WPIRoboticsEngineering/ZenDriver/README.md

# ZenDriver
