WPIRoboticsEngineering/ZenDriver/PCBWay-BOM.xls

 |  |  | xxxx xxxx xxxxx xxPCS BOM (Sample Bill of Materials)
Item # | *Designator | *Qty | Manufacturer | *Mfg Part # | Substitute | Description / Value | *Package/Footprint | Type | Your Instructions / Notes
1 | C1 C15 C16 C17 | 2 | "United Chemi-Con" | "EMVE160ADA221MF80G" |  | "CAP ALUM 220UF 20% 16V SMD" | Nonstandard | SMD
2 | C13 C14 | 2 | "Samsung Electro-Mechanics" | "CL10A475KO8NNNC" | Yes, with equiv | "CAP CER 4.7UF 16V X5R 0603" | SMD 0603 | SMD
3 | C3 C10 C11 C12 C2 | 5 | "Yageo" | "CC0603MRX5R7BB106" | Yes, with equiv | "CAP CER 10UF 16V X5R 0603" | SMD 0603 | SMD
4 | C4 C5 C6 C7 C8 C21 | 6 | "Samsung Electro-Mechanics" | "CL10B104KO8NNNC" | Yes, with equiv | "CAP CER 0.1UF 16V X7R 0603" | SMD 0603 | SMD
5 | C9 | 1 | "Samsung Electro-Mechanics" | "CL10B105KP8NNNC" | Yes, with equiv | "CAP CER 1UF 10V X7R 0603" | SMD 0603 | SMD
6 | D1 | 1 | "Nexperia USA Inc." | "PDZ3.3B |  | "DIODE ZENER 3.3V 400MW SOD323" | SOD323 | SMD
7 | D2 D4 D5 | 3 | "Nexperia USA Inc." | "PMEG4005EJ |  | "DIODE SCHOTTKY 40V 500MA SOD323F" | SOD323F | SMD
8 | D3 | 1 | "Nexperia USA Inc." | "PMEG4005EJ |  | "DIODE SCHOTTKY 40V 500MA SOD323F" | SOD323F | SMD
9 | D8 | 1 | "Würth Elektronik" | "150060RS75000" | Yes, with equiv | "LED RED CLEAR 0603 SMD" | SMD 0603 | SMD
10 | J1 | 1 | "Adam Tech" | "PH1-04-UA" | yes | "CONN HEADER VERT 4POS 2.54MM" | PTH | thru-hole
11 | J10 | 1 | "JST Sales America Inc." | "SM06B-GHS-TB(LF)(SN)" | yes | "CONN HEADER SMD R/A 6POS 1.25MM" | PTH | thru-hole
12 | J11 | 1 | "JST Sales America Inc." | "SM02B-PASS-TBT(LF)(SN)" | yes | "CONN HEADER SMD R/A 2POS 2MM" | PTH | thru-hole
13 | J12 J13 | 2 | Samtec Inc. | “‎SLW-106-01-T-S‎” |  | CONN RCPT 6POS 0.1 TIN PCB | PTH | thru-hole
14 | J2 | 1 | "Sullins Connector Solutions" | "PPTC191LFBN-RC" | yes | "CONN HDR 19POS 0.1 TIN PCB" | PTH | thru-hole
15 | J4 J3 | 2 | "Sullins Connector Solutions" | "PPPC031LFBN-RC" | yes | "CONN HDR 3POS 0.1 GOLD PCB" | PTH | thru-hole
16 | J5 J14 J15 | 3 | "Sullins Connector Solutions" | "PPPC121LFBN-RC" | yes | "CONN HDR 12POS 0.1 GOLD PCB" | PTH | thru-hole
17 | J6 | 1 | "Sullins Connector Solutions" | "PPPC192LFBN-RC" | yes | "CONN HDR 38POS 0.1 GOLD PCB" | PTH | thru-hole
18 | J7 | 1 | "Adam Tech" | "PH1-04-UA" |  | "CONN HEADER VERT 4POS 2.54MM" | PTH | thru-hole
19 | J8 | 1 | "Sullins Connector Solutions" | "PPPC061LFBN-RC" | yes | "CONN HDR 6POS 0.1 GOLD PCB" | PTH | thru-hole
20 | J9 | 1 | "Sullins Connector Solutions" | "PPPC041LFBN-RC" | yes | "CONN HDR 4POS 0.1 GOLD PCB" | PTH | thru-hole
21 | L1 | 1 | "Murata Electronics" | "1255AY-4R7M=P3" |  | "FIXED IND 4.7UH 4A 27.6 MOHM SMD" | Nonstandard | SMD
22 | Q2 Q1 | 2 | "Vishay Siliconix" | "SI7415DN-T1-E3" |  | "MOSFET P-CH 60V 3.6A 1212-8" | PowerPAK® 1212-8 | SMD
23 | R1 R9 R10 | 3 | "Stackpole Electronics Inc" | "RNCP0603FTD10K0" | Yes, with equiv | "RES 10K OHM 1% 1/8W 0603" | SMD 0603 | SMD
24 | R2 | 1 | "Yageo" | "RT0603FRE07270KL" | Yes, with equiv | "RES SMD 270K OHM 1% 1/10W 0603" | SMD 0603 | SMD
25 | R25 | 1 | "Stackpole Electronics Inc" | "RMCF0603JT330R" | Yes, with equiv | "RES 330 OHM 5% 1/10W 0603" | SMD 0603 | SMD
26 | R3 | 1 | “Bourns Inc.” | “CR0603-FX-5112ELF” | Yes, with equiv | 51.1 ±1% 0.1W, 1/10W Chip Resistor 0603 (1608 Metric) Moisture Resistant Thick Film | SMD 0603 | SMD
27 | R4 | 1 | "Yageo" | "RC0603FR-0722R1L" | Yes, with equiv | "RES SMD 22.1 OHM 1% 1/10W 0603" | SMD 0603 | SMD
28 | R5 | 1 | "Stackpole Electronics Inc" | "RMCF0603FT7K68" | Yes, with equiv | "RES 7.68K OHM 1% 1/10W 0603" | SMD 0603 | SMD
29 | R6 | 1 | "Stackpole Electronics Inc" | "RMCF0603FT41K2" | Yes, with equiv | "RES 41.2K OHM 1% 1/10W 0603" | SMD 0603 | SMD
30 | R7 R8 R17 R15 R16 R14 | 6 | "Stackpole Electronics Inc" | "RMCF0603FG100K" | Yes, with equiv | "RES 100K OHM 1% 1/10W 0603" | SMD 0603 | SMD
31 | SW1 | 1 | "Nidec Copal Electronics" | "CSS-1210TB" |  | "SWITCH SLIDE SPDT 100MA 12V" | Nonstandard | SMD
32 | SW2 | 1 | "Nidec Copal Electronics" | "CSS-1210TB" |  | "SWITCH SLIDE SPDT 100MA 12V" | Nonstandard | SMD
33 | U1 | 1 | "Monolithic Power Systems Inc." | "MP4423HGQ-Z" |  | "IC REG BUCK ADJUSTABLE 3A 8QFN" | 8QFN | SMD
34 | U3 U2 | 2 | "Texas Instruments" | "DRV8838DSGT" |  | "IC BRIDGE DRIVER PAR 8WSON" | 8WSON | SMD
35 | U5 | 1 | "STMicroelectronics" | "LSM6DS33TR" |  | "IMU ACCEL/GYRO I2C/SPI 16LGA" | 16LGA | SMD
36 | U4 | 1 | "Vishay Semiconductor Opto Division" | "TSSP58038" |  | "SENSOR REMOTE REC 38.0KHZ 25M" | PTH | thru-hole
