WPIRoboticsEngineering/ZenDriver/outline.dxf

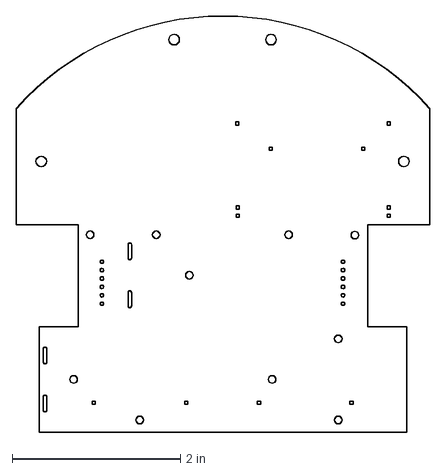
[picture p1: CAD file, 2020-09-22]
outline.dxf
4.93 x 4.95 in
