WPIRoboticsEngineering/ZenDriver/(list of files, drawings)

Other design files:
Romi-unified-board.dsn
