WPIRoboticsEngineering/ZenDriver/Romi-unified-board-2layer.kicad_pcb

## KiCad design Romi-unified-board-2layer.kicad_pcb (2021-03-24)

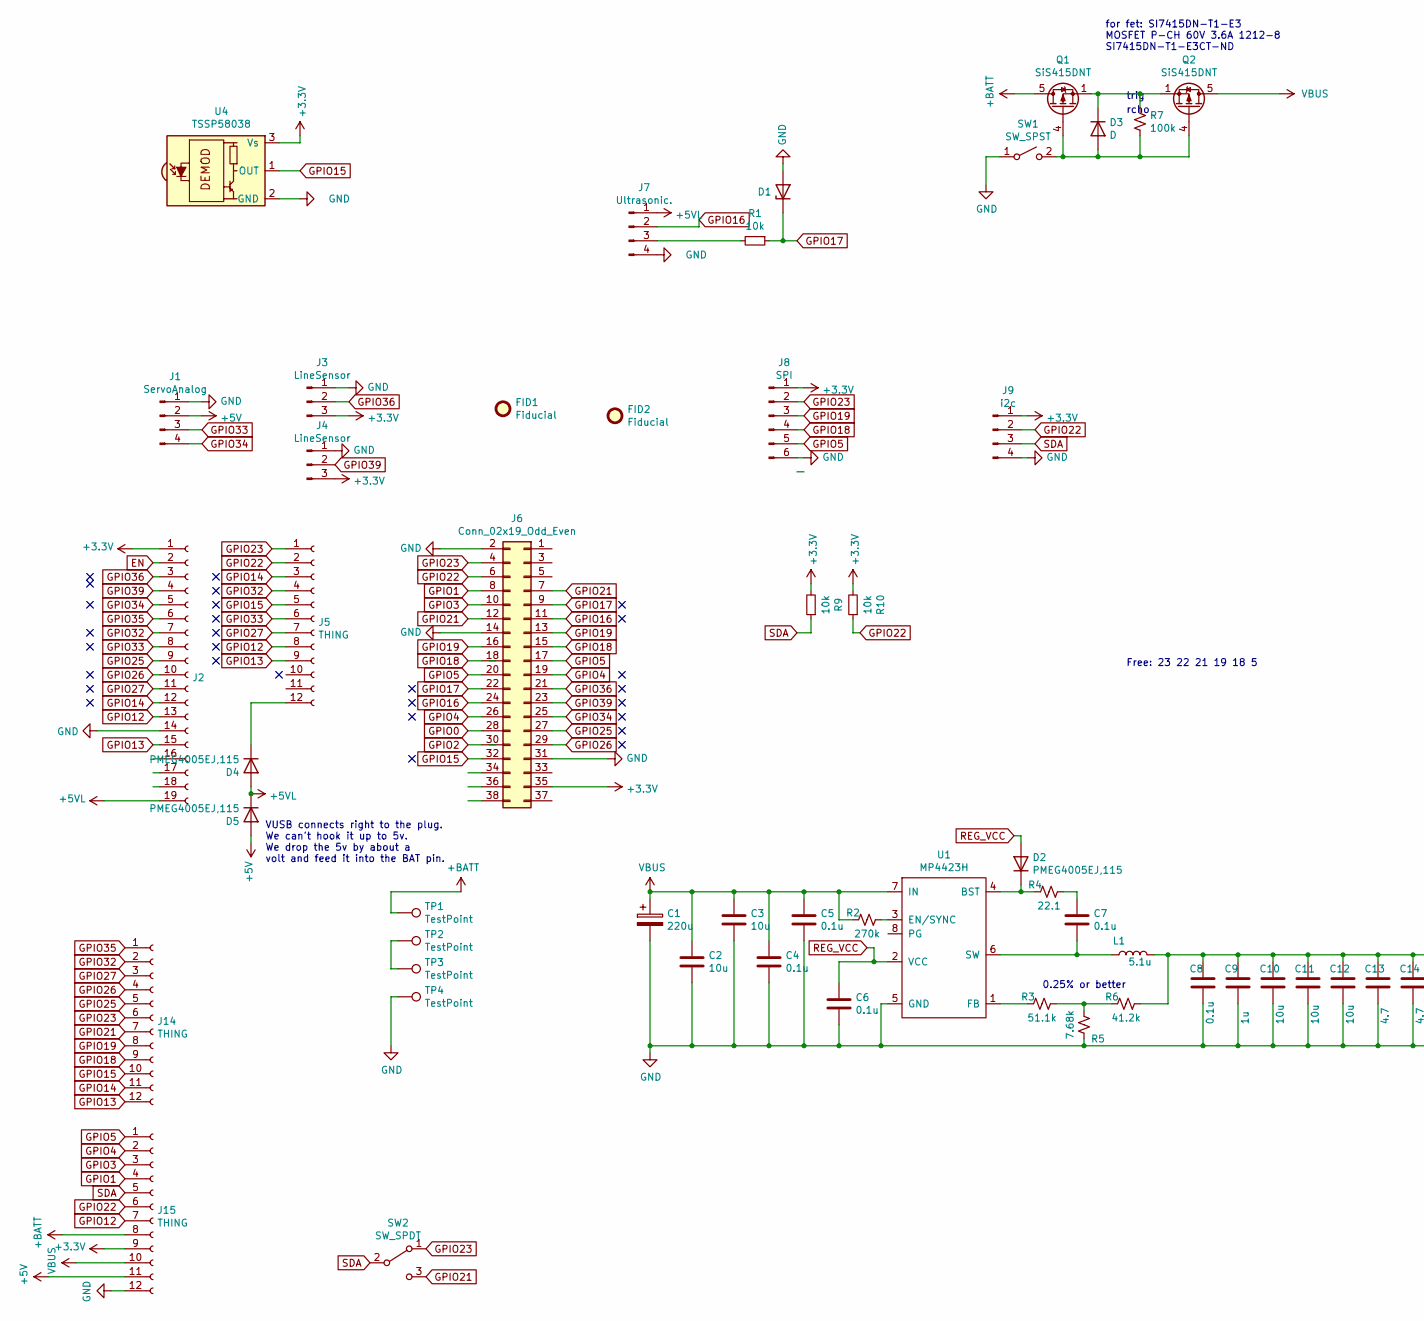
[picture p2: schematic Romi-unified-board-2layer.sch, part in row 1, column 1]

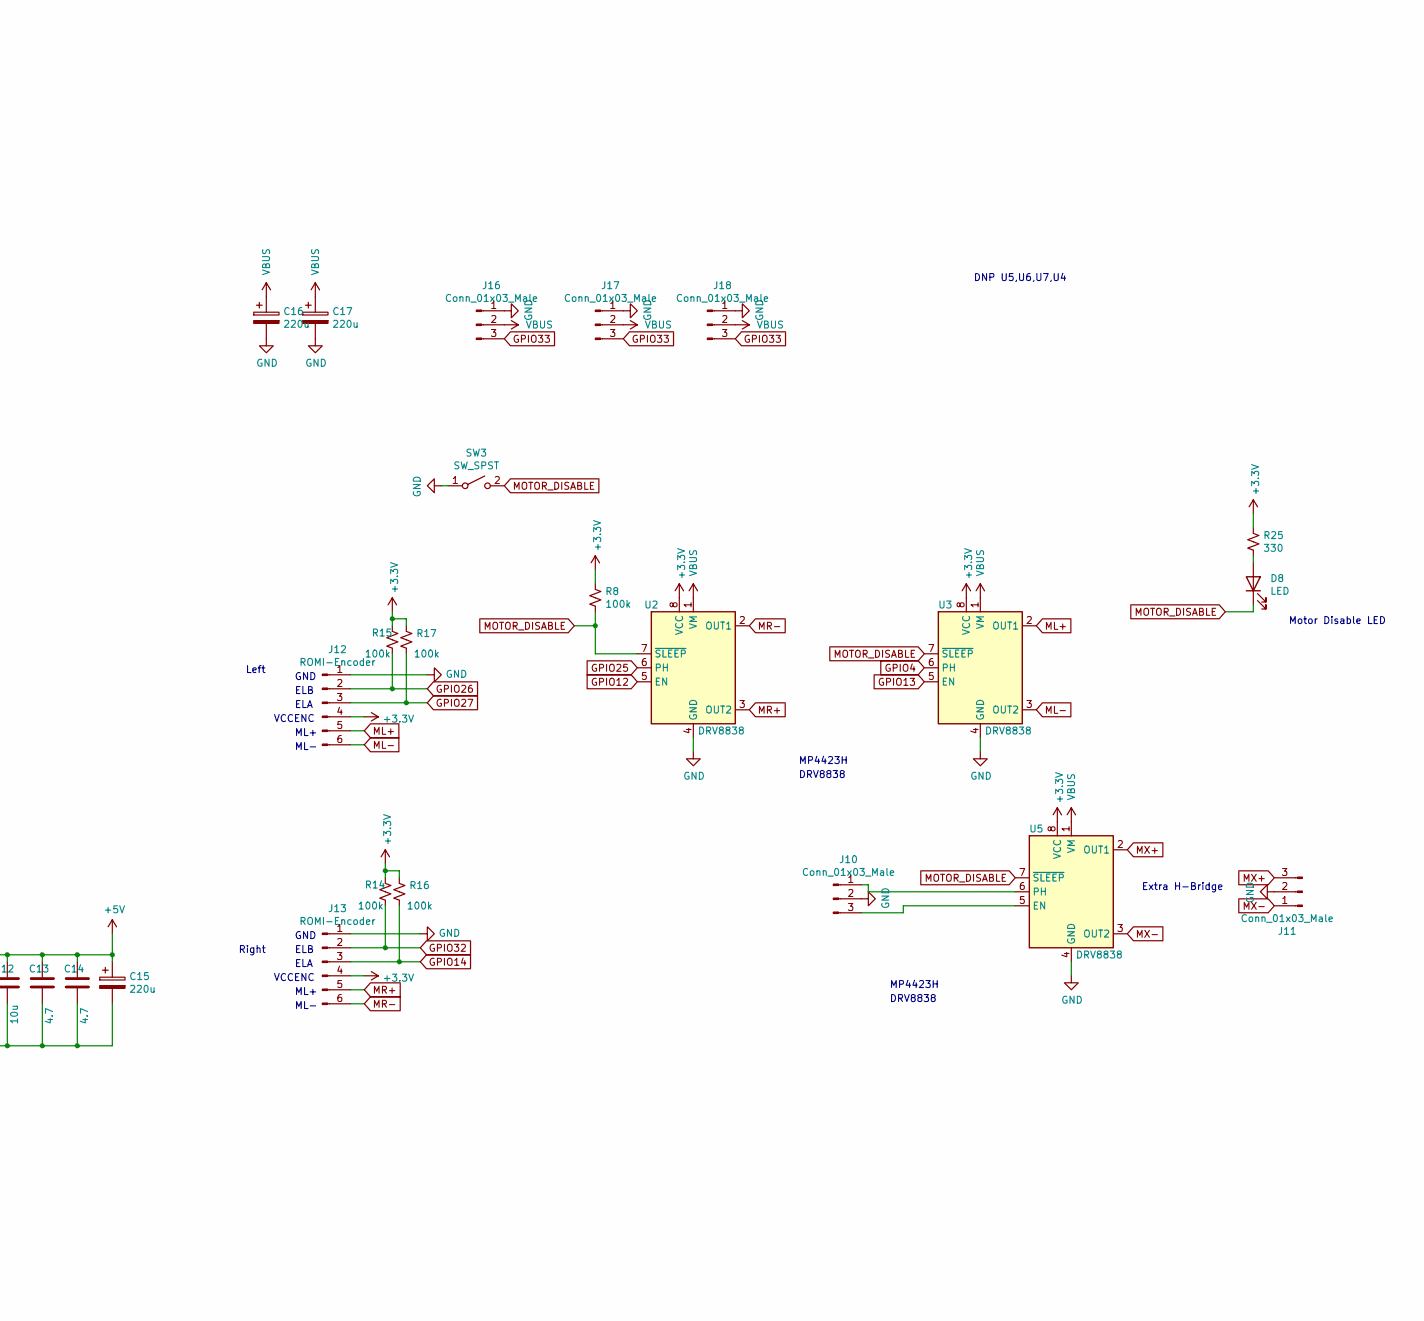
[picture p3: schematic Romi-unified-board-2layer.sch, part in row 1, column 2]

Parts:
C1, C15, C16, C17: 220u; CP_Elec_6.3x3.9
C2, C3, C10, C11, C12: 10u; C_0603_1608Metric
C4, C5, C6, C7, C8: 0.1u; C_0603_1608Metric
C9: 1u; C_0603_1608Metric
C13, C14: 4.7; C_0603_1608Metric
D1: D_Zener; D_SOD-323F
D2, D4, D5: PMEG4005EJ,115; D_SOD-323F
D3: D; D_SOD-323F
D8: LED; LED_0603_1608Metric
FID1, FID2: Fiducial; Fiducial_1mm_Mask2mm
J1: ServoAnalog; PinSocket_1x04_P2.54mm_Vertical
J2: Conn_01x19_Female; PinSocket_1x19_P2.54mm_Vertical
J3, J4: LineSensor; PinSocket_1x03_P2.54mm_Vertical
J5, J14, J15: THING; PinSocket_1x12_P2.54mm_Vertical
J6: Conn_02x19_Odd_Even; PinSocket_2x19_P2.54mm_Vertical
J7: Ultrasonic.; PinSocket_1x04_P2.54mm_Vertical
J8: SPI; PinSocket_1x06_P2.54mm_Vertical
J9: i2c; PinSocket_1x04_P2.54mm_Vertical
J10, J11: Conn_01x03_Male; PinSocket_1x03_P2.54mm_Vertical
J12, J13: ROMI-Encoder; PinSocket_1x06_P2.54mm_Vertical
J16, J17, J18: Conn_01x03_Male; JST_PH_B3B-PH-K_1x03_P2.00mm_Vertical
L1: 5.1u; L_6.3x6.3_H3
Q1, Q2: SiS415DNT; Vishay_PowerPAK_1212-8_Single
R1, R9, R10: 10k; R_0603_1608Metric
R2: 270k; R_0603_1608Metric
R3: 51.1k; R_0603_1608Metric
R4: 22.1; R_0603_1608Metric
R5: 7.68k; R_0603_1608Metric
R6: 41.2k; R_0603_1608Metric
R7, R8, R14, R15, R16, R17: 100k; R_0603_1608Metric
R25: 330; R_0603_1608Metric
SW1, SW3: SW_SPST; SS12D06L5
SW2: SW_SPDT; SS12D06L5
TP1, TP2, TP3, TP4: TestPoint; batterylug
U1: MP4423H
U2, U3, U5: DRV8838; WSON-8-1EP_2x2mm_P0.5mm_EP0.9x1.6mm
U4: TSSP58038; Vishay_MINICAST-3Pin

Connections:
+3V3: J2.1, J3.3, J4.3, J6.35, J8.1, J9.1, J12.4, J13.4, J15.9, R8.1, R9.2, R10.2, R14.1, R15.1, R16.1, R17.1, R25.1, U2.8 (VCC), U3.8 (VCC), U4.3 (Vs), U5.8 (VCC)
+5V: C8.1, C9.1, C10.1, C11.1, C12.1, C13.1, C14.1, C15.1, D5.2 (A), J1.2, J15.11, L1.2, R6.1
+5VL: D4.2 (A), D5.1 (K), J2.19, J7.1
+BATT: J15.8, Q1.5 (D), TP1.1
EN: J2.2
GPIO0: J6.28
GPIO1: J6.8, J15.4
GPIO2: J6.30
GPIO3: J6.10, J15.3
GPIO4: J6.19, J6.26, J15.2, U3.6 (PH)
GPIO5: J6.17, J6.20, J8.5, J15.1
GPIO12: J2.13, J5.8, J15.7, U2.5 (EN)
GPIO13: J2.15, J5.9, J14.12, U3.5 (EN)
GPIO14: J2.12, J5.3, J13.3, J14.11, R16.2
GPIO15: J5.5, J6.32, J14.10, U4.1 (OUT)
GPIO16: J6.11, J6.24, J7.2
GPIO17: D1.1 (K), J6.9, J6.22, R1.1
GPIO18: J6.15, J6.18, J8.4, J14.9
GPIO19: J6.13, J6.16, J8.3, J14.8
GPIO21: J6.7, J6.12, J14.7, SW2.3 (C)
GPIO22: J5.2, J6.6, J9.2, J15.6, R10.1
GPIO23: J5.1, J6.4, J8.2, J14.6, SW2.1 (A)
GPIO25: J2.9, J6.27, J14.5, U2.6 (PH)
GPIO26: J2.10, J6.29, J12.2, J14.4, R15.2
GPIO27: J2.11, J5.7, J12.3, J14.3, R17.2
GPIO32: J2.7, J5.4, J13.2, J14.2, R14.2
GPIO33: J1.3, J2.8, J5.6, J16.3, J17.3, J18.3
GPIO34: J1.4, J2.5, J6.25
GPIO35: J2.6, J14.1
GPIO36: J2.3, J3.2, J6.21
GPIO39: J2.4, J4.2, J6.23
ML+: J12.5, U3.2 (OUT1)
ML-: J12.6, U3.3 (OUT2)
MOTOR_DISABLE: D8.1 (K), R8.2, SW3.2 (B), U2.7 (~SLEEP), U3.7 (~SLEEP), U5.7 (~SLEEP)
MR+: J13.5, U2.3 (OUT2)
MR-: J13.6, U2.2 (OUT1)
MX+: J11.3, U5.2 (OUT1)
MX-: J11.1, U5.3 (OUT2)
unnamed: C7.1, R4.1
unnamed: C7.2, L1.1, U1.6 (SW)
unnamed: D2.1 (K), R4.2, U1.4 (BST)
unnamed: D3.1 (K), Q1.1 (S), Q1.2 (S), Q1.3 (S), Q2.1 (S), Q2.2 (S), Q2.3 (S), R7.1
unnamed: D3.2 (A), Q1.4 (G), Q2.4 (G), R7.2, SW1.2 (B)
unnamed: D4.1 (K), J5.12
unnamed: D8.2 (A), R25.2
unnamed: J7.3, R1.2
unnamed: J10.3, U5.5 (EN)
unnamed: R2.1, U1.3 (EN/SYNC)
unnamed: R3.1, R5.2, R6.2
unnamed: R3.2, U1.1 (FB)
unnamed: TP2.1, TP3.1
REG_VCC: C6.1, D2.2 (A), U1.2 (VCC)
SDA: J9.3, J15.5, R9.1, SW2.2 (B)
VBUS: C1.1, C2.1, C3.1, C4.1, C5.1, C16.1, C17.1, J15.10, J16.2, J17.2, J18.2, Q2.5 (D), R2.2, U1.7 (IN), U2.1 (VM), U3.1 (VM), U5.1 (VM)

Notes on the sheet:
MP4423H
DRV8838
for fet: SI7415DN-T1-E3 MOSFET P-CH 60V 3.6A 1212-8 SI7415DN-T1-E3CT-ND
0.25% or better
GND
ELB
ELA
VCCENC
ML+
ML-
ELA
trig
rcho
Left
Right
Free: 23 22 21 19 18 5
VUSB connects right to the plug. We can't hook it up to 5v. We drop the 5v by about a volt and feed it into the BAT pin.
DNP U5,U6,U7,U4
Motor Disable LED
Extra H-Bridge

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
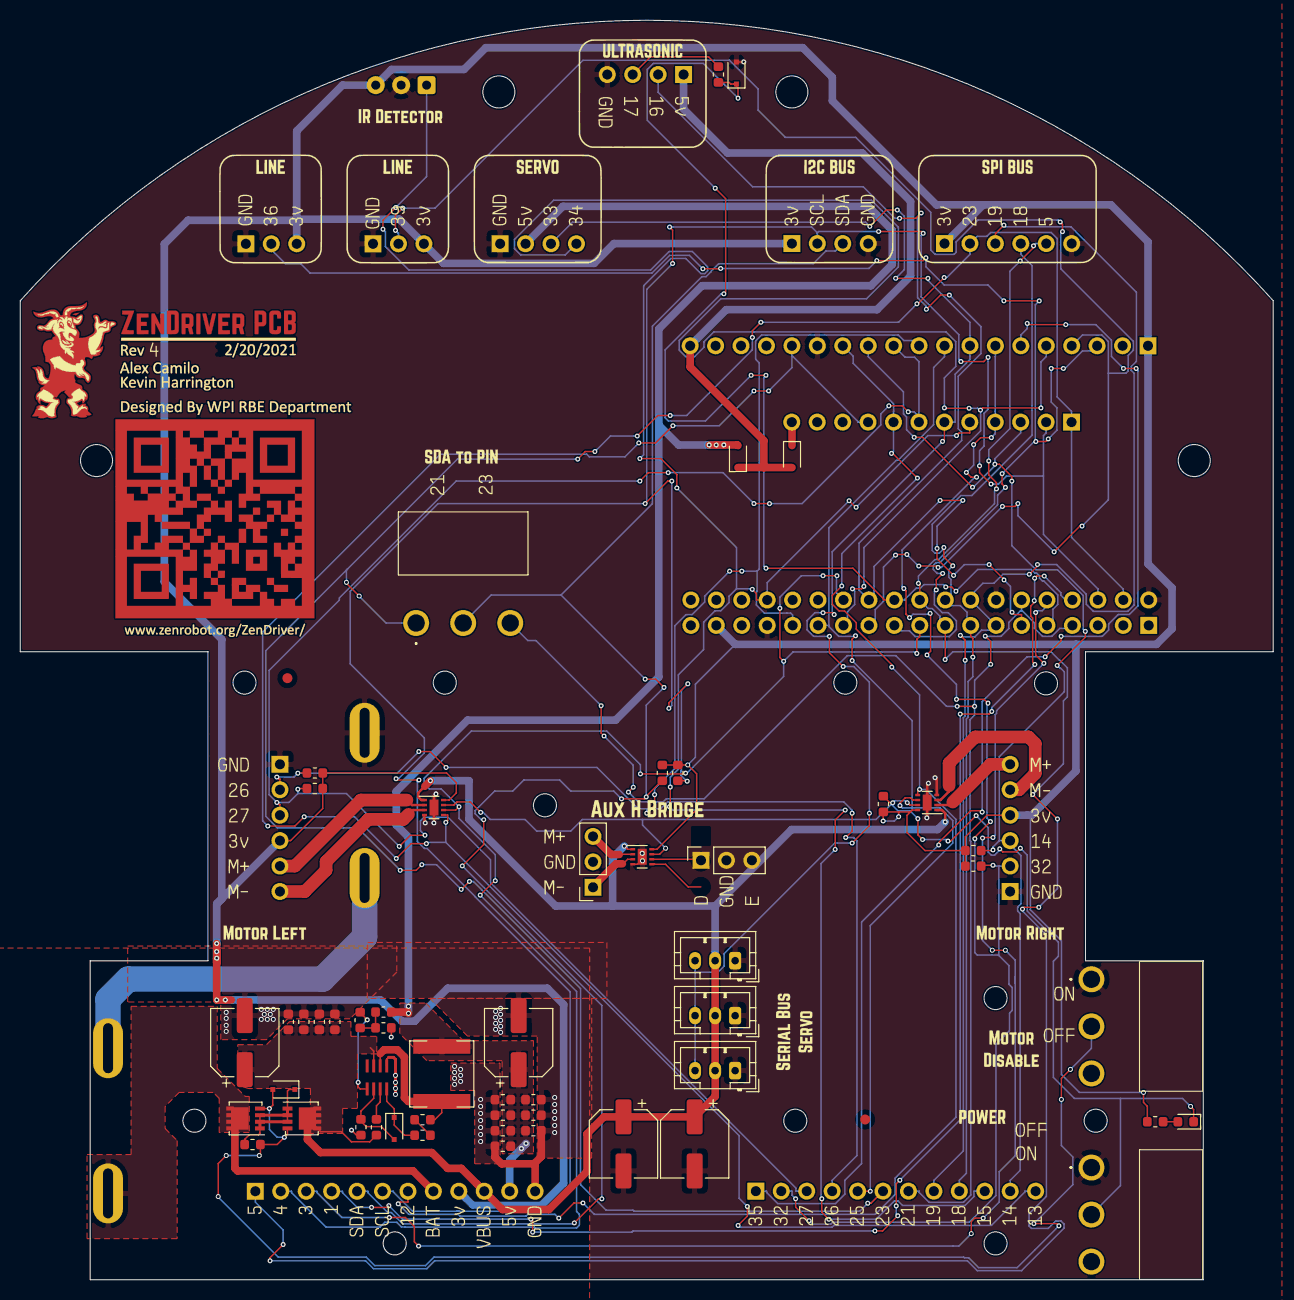
[picture p4: board Romi-unified-board-2layer.kicad_pcb from above]

Board: 4 copper layers, 125.1 x 125.8 mm, 75 parts (0 on the bottom side), 53 nets.

Other parts of the board:
Ref**: Val**; Romi-unified-board-F_Cu-rev4
Ref**#2: Val**; AuxHBridgeLabel
