WPIRoboticsEngineering/ZenDriver/jig.kicad_pcb

## KiCad design jig.kicad_pcb (2020-12-18)

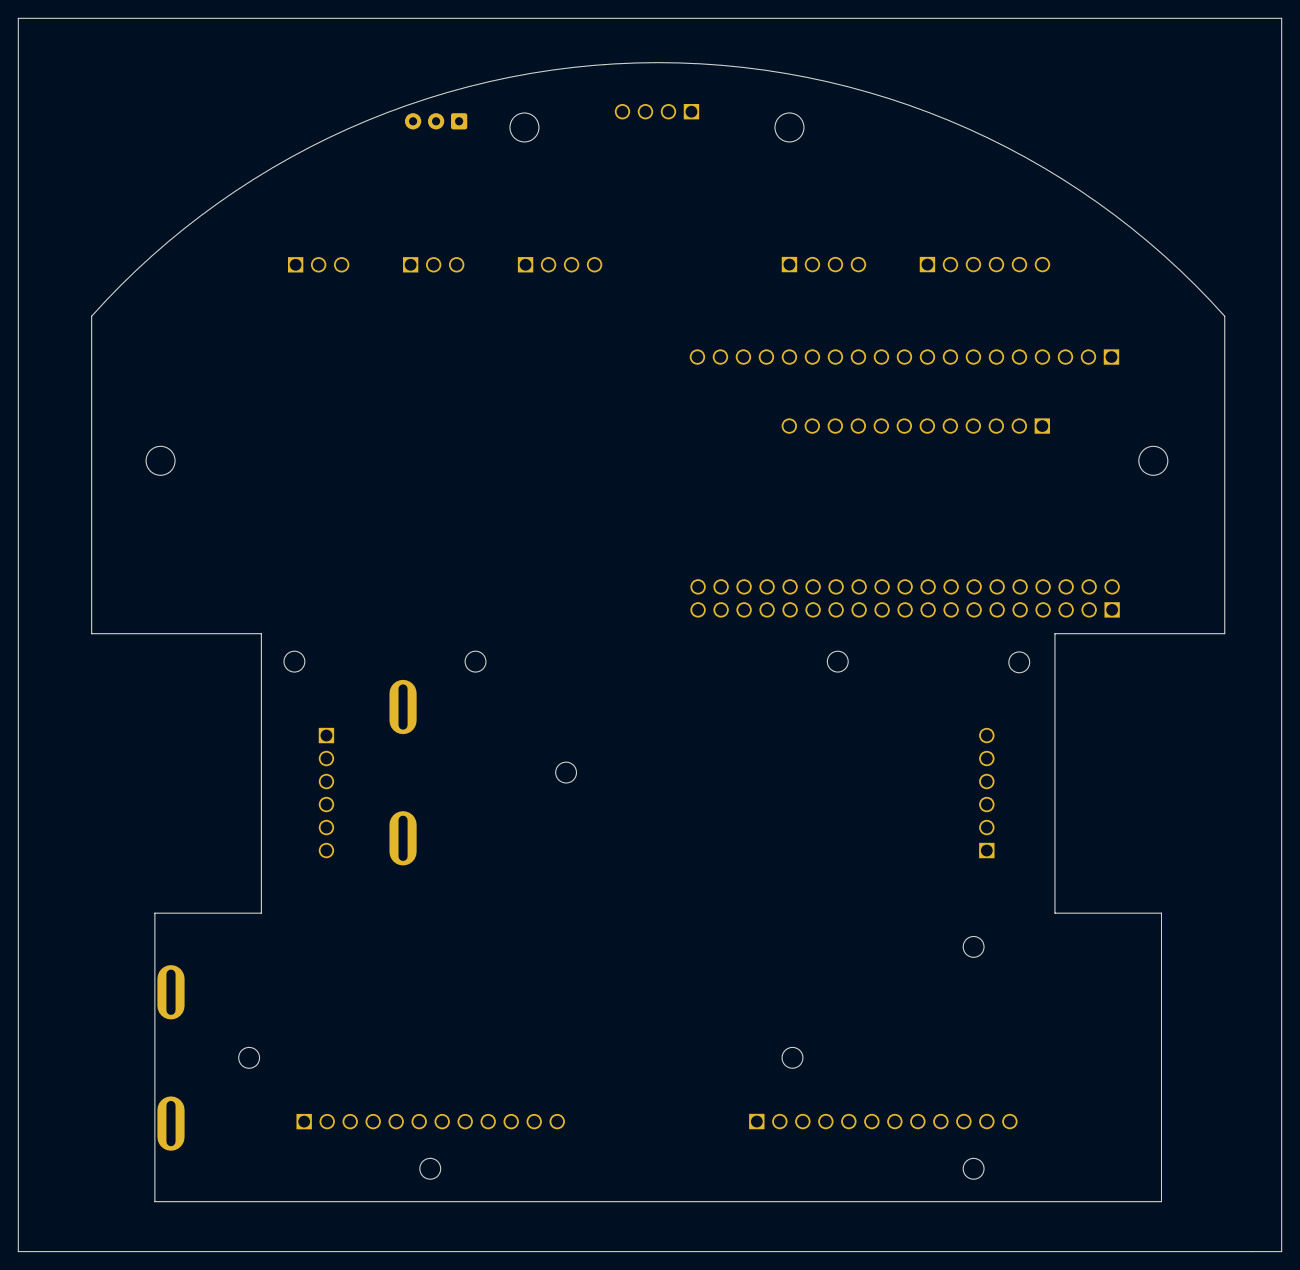
[picture p5: board jig.kicad_pcb from above]

Board: 4 copper layers, 139.5 x 136.2 mm, 18 parts (0 on the bottom side), 31 nets, no tracks yet.

Parts:
J1: ServoAnalog; PinSocket_1x04_P2.54mm_Vertical
J2: Conn_01x19_Female; PinSocket_1x19_P2.54mm_Vertical
J3, J4: LineSensor; PinSocket_1x03_P2.54mm_Vertical
J5, J14, J15: THING; PinSocket_1x12_P2.54mm_Vertical_1_3mm
J6: Conn_02x19_Odd_Even; PinSocket_2x19_P2.54mm_Vertical
J7: Ultrasonic.; PinSocket_1x04_P2.54mm_Vertical
J8: SPI; PinSocket_1x06_P2.54mm_Vertical_1_3mm
J9: i2c; PinSocket_1x04_P2.54mm_Vertical
J12, J13: ROMI-Encoder; PinSocket_1x06_P2.54mm_Vertical_1_3mm
TP1, TP2, TP3, TP4: TestPoint; batterylug
U4: TSSP58038; Vishay_MINICAST-3Pin

Connections:
+3V3: J2.1, J3.3, J4.3, J6.35, J8.1, J9.1, J12.4, J13.4, J15.9, U4.3
+5V: J1.2, J15.11
+5VL: J2.19, J7.1
+BATT: J15.8, TP1.1
GND: J1.1, J2.14, J3.1, J4.1, J6.2, J6.14, J6.31, J7.4, J8.6, J9.4, J12.1, J13.1, J15.12, TP4.1, U4.2
GPIO1: J6.8, J15.4
GPIO3: J6.10, J15.3
GPIO4: J6.19, J6.26, J15.2
GPIO5: J6.17, J6.20, J8.5, J15.1
GPIO12: J2.13, J5.8, J15.7
GPIO13: J2.15, J5.9, J14.12
GPIO14: J2.12, J5.3, J13.3, J14.11
GPIO15: J5.5, J6.32, J14.10, U4.1
GPIO16: J6.11, J6.24, J7.2
GPIO17: J6.9, J6.22
GPIO18: J6.15, J6.18, J8.4, J14.9
GPIO19: J6.13, J6.16, J8.3, J14.8
GPIO21: J6.7, J6.12, J14.7
GPIO22: J5.2, J6.6, J9.2, J15.6
GPIO23: J5.1, J6.4, J8.2, J14.6
GPIO25: J2.9, J6.27, J14.5
GPIO26: J2.10, J6.29, J12.2, J14.4
GPIO27: J2.11, J5.7, J12.3, J14.3
GPIO32: J2.7, J5.4, J13.2, J14.2
GPIO33: J1.3, J2.8, J5.6
GPIO34: J1.4, J2.5, J6.25
GPIO35: J2.6, J14.1
GPIO36: J2.3, J3.2, J6.21
GPIO39: J2.4, J4.2, J6.23
unnamed: TP2.1, TP3.1
SDA: J9.3, J15.5
