WPIRoboticsEngineering/ZenDriver/(threads)

Thread 1 (2020-09-22):

Missing pullup on /SLP for one of the motor drivers.

gcl8a, 2020-09-22:

acamilo, 2020-09-24:
They're both connected to GPIO15 and share a pullup

Closed 2020-09-24.

Thread 2 (2020-09-22):

I don't understand J6

gcl8a, 2020-09-22:
Isn't this the 2x header? I thought it was going to just breakout the pins, but it looks like one side holds the Thing and the other the DEV board. I must be missing something?

acamilo, 2020-09-24:
This is there to make the footprint a little more compact.

The board is pushed up right to the plastic on the romi.
You can only add PTH components in very specific places on the back where there are cutouts in the plastic.
I can't raise the board because the headers for the encoders don't give me any room.
I'm limited to sticking the module towards the front of the board where the headers should go.

This is how the boards are attatched.
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

now that i look at it, something is wrong with the pinout, need to fix that.

Closed 2020-09-24.

Thread 3 (2020-09-22):

Pin 23 on the SPI connector conflicts with I2C

gcl8a, 2020-09-22:
Using a Thing, 23 is used as the SDA (typically). Which means it conflict with the pin in the SPI connector.

Not sure why there are five pins in the SPI connector.

GPIO2 doesn't exist on the Thing, so then there's no CS pin there.

acamilo, 2020-09-24:
Kevin asked me to break out GPIO2 and I stuck it on that header.

JP1 will swap between 23 and 21. It's a cuttable and solderable jumper.
Should we make it a DIP switch or something?

gcl8a, 2020-09-24:
I’d use a DIP. In the event we go back and forth.

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

acamilo, 2020-09-25:
Ok, I can swap it out.

Closed 2020-09-25.

Thread 4 (2020-09-22):

IMU

gcl8a, 2020-09-22:
I thought the plan was to have a separate IMU, not one mounted on the PCB.

acamilo, 2020-09-24:
That's still the plan. For now I expect us to ignore this in the classes.

Accelerometers are pretty cheap these days. I added it to give the board some life outside of the classes, Or to keep that option open if we want to use the board somewhere else.  This is also why the LIDAR connector is on there.

Closed 2020-09-24.

Thread 6 (2020-09-25):

Replace JP1 with a switch.

acamilo, 2020-09-25:
We want to be able to switch the i2c pin without having to cut or solder.

Closed 2020-10-08.

Thread 8 (2020-10-27):

Add the line driver chip to Serial2 (pins 16 and 17) using Pin 19 as line enable for the LewanSoul motors

madhephaestus, 2020-10-27:
I tested this out with the baby yoda and it worked well. It would allow us to add arbitrarily more motors to the 1001 kits using the bus style connections.

Add 3 sockets to the bus to distribute the current load.

acamilo, 2020-10-27:
Is there another set of pins we can use?
16 and 17 are going to the LIDAR connector.  It would be nice to have both lidar and LS motors.

madhephaestus, 2020-10-27:
same pins for the same reason, its the only availible hardware serial port

acamilo, 2020-10-27:
You can use the GPIO matrix to route the uart pins to free GPIO.

acamilo, 2020-10-27:
See chapter 5 of this document
https://www.espressif.com/sites/default/files/documentation/esp32_technical_reference_manual_en.pdf

acamilo, 2020-10-27:
You might be able to mux TX and RX as well without an external chip.

madhephaestus, 2020-10-27:
yeah i was looking into that, ill try it on Yoda

acamilo, 2020-10-28:
What power rail should I use? 5v or battery?

madhephaestus, 2020-10-29:
battery

acamilo, 2020-10-31:
Added 3 lewansoul connectors to rev 2. No buffer, directly connected to GPIO33

Closed 2020-10-31.

Thread 9 (2020-10-28):

Wish list

gcl8a, 2020-10-28:
Reverse the order of the ultrasonic pins (w.r.t. V2) so that the ultrasonic can be put in the socket and faces forward.

Add a three-pin socket for an IR remote detector (e.g., https://www.pololu.com/product/2462). Would need to go to a digital pin with an external interrupt. (I used pin 34 to test, but that is reserved for the servo feedback, yes?)

acamilo, 2020-10-29:
The HC-04 pinout should be correct.
https://media.digikey.com/Photos/Adafruit%20Industries%20LLC/MFG_3942.jpg

acamilo, 2020-10-29:
Added socket for IR Detector.

Closed 2020-10-31.

Thread 10 (2020-10-30):

Ultrasonic Problems

madhephaestus, 2020-10-30:
triger needs to be next to 5v
Echo needs to be next to gnd
Echo needs the in-line resistor and Zener clamping
to face the sensor forwars the 5v is to the side labled "right motor"
to face forward, the gnd should be to the side labled left motor

madhephaestus, 2020-10-30:
To test, change the header file to set the pins you are using (different then current version)

// Ultrasonics
#define SIDE_ULTRASONIC_TRIG 16
#define SIDE_ULTRASONIC_ECHO 17

Closed 2020-10-31.

Thread 12 (2020-10-30):

Missing pin wiring

madhephaestus, 2020-10-30:
GPIO 12, 14 27 and 13 are not wired causing both motor drivers and both encoders to not work.

acamilo, 2020-10-31:
I suspect you have a bad solder joint on your unit.
the left driver on my unit is working well.
I recomend flux and reflow with hot air for your board

acamilo, 2020-10-31:
These pins have been reconnected in the schematic

Closed 2020-10-31.

Thread 13 (2020-10-30):

Labels for Left Motor and Right motor missing

madhephaestus, 2020-10-30:
the motor closest to the Gompie label is the Left motor
The motor closest to the ESP is the right motor

Closed 2020-11-01.

Thread 14 (2020-10-30):

Swap the ultrasonic header in the BOM from male to female

madhephaestus, 2020-10-30:

Closed 2020-11-01.

Thread 15 (2020-10-31):

Ultrasonic Rangefinder returning erroneous results when used with the ESP32 Thing Plus

acamilo, 2020-10-31:

acamilo, 2020-12-10:
Looks like this was a soldering problem, the new boards don't have this issue.

Closed 2020-12-10.

Thread 16 (2020-10-31):

Swap encoder GPIO.

acamilo, 2020-10-31:
A and B are swapped on both encoders
encoder 1 and 2 need to be swapped.

This is the config that works:
#define MOTOR_RIGHT_ENCB 26
#define MOTOR_RIGHT_ENCA 27
#define MOTOR_LEFT_ENCB 32
#define MOTOR_LEFT_ENCA 14

It needs to be this
#define MOTOR_LEFT_ENCA 26
#define MOTOR_LEFT_ENCB 27
#define MOTOR_RIGHT_ENCA 32
#define MOTOR_RIGHT_ENCB 14

acamilo, 2020-11-01:
in 0.9.3/RBE1001.h the left encoder pinout matches BOTH the shim and the zen
but the right side has a and B swapped. This is to ensure motors spin in same direction.

4 and 13 go to ROMI Driver BOARD LEFT  and 12 and 25 go to ROMI DRIVER BOARD RIGHT
so, to EXACTLY MATCH the SHIM. 4/13 and 25/12 need to be SWAPPED at U2 and U3.
and the AB swap in the header file is a feature and should not be made on the PCB.

madhephaestus, 2020-11-01:
The PCB should exactly match behavior of the 0.9.4 code running on the v3 shim. The same code running on a v3 shim must be interchangeable with the behavior of this module. The v3 shim was tested in terms of functionality and approved given the 0.9.4 software.

acamilo, 2020-11-01:
| 0.9.4 h file                          | shim |
| ----------------------------|-------|
| MOTOR_LEFT_PWM 13     |     13 |
| MOTOR_LEFT_DIR 4          |     4   |
|  MOTOR_RIGHT_PWM 12 |    12 |
| MOTOR_RIGHT_DIR 25    |     25  |
|  MOTOR_LEFT_ENCA 27  |     27  |
| MOTOR_LEFT_ENCB 26   |      26 |
| MOTOR_RIGHT_ENCA 32 |  14 ! |
| MOTOR_RIGHT_ENCB 14  | 32 ! |

Please confirm the swap on the right encoder is intentional.

madhephaestus, 2020-11-01:
the v2 and v3 are backwards, the v2 is top of the repo in 0.10.0, please do not look at 0.10.0 thats exists to deal with the errors this term. version 0.9.4 is correct.

acamilo, 2020-11-01:
Ok, I have checked 0.9.4 against the v3 shim.
and the v3 shim matches the edits in the v2 zen PCB.

I think we're all set with the motors and encoders.

Closed 2020-11-01.

Thread 17 (2020-10-31):

Add a Diode so the 5v doesn't back-feed the motors when only powered from USB.

acamilo, 2020-10-31:

acamilo, 2020-10-31:
Added diode, fixes the back-power problem completely

Closed 2020-10-31.

Thread 18 (2020-11-11):

Swap Right Motor M+ M-

acamilo, 2020-11-11:
The romi board swaps these.

Thread 19 (2020-11-11):

Fix Slide Switch Footprint

acamilo, 2020-11-11:
The center pin is in the wrong position.

Thread 21 (2020-12-08):

Mount holes for top plate do not line up with holes on bottom

madhephaestus, 2020-12-08:
On the top plate there are 2 holes that are recessed 0.125" These are designed to mate with a 1" standoff and keep the top plate close to the wheels. THe mating holes on the ZenDriver do not exist.

acamilo, 2020-12-10:
Do you want the standoff to sit on top of the PCB or do you want the holes to be large enough so it sits on the plastic below?

madhephaestus, 2020-12-10:
standoff sits on the PCB like a normal romi board

Thread 24 (2020-12-08):

Ultrasonic label is reversed from others

madhephaestus, 2020-12-08:
The labels on the Ultrasonic header are reversed from the other labeles. One should be able to read them in the same orentation

Thread 26 (2020-12-10):

Need Board Diagram Documentation

madhephaestus, 2020-12-10:
Need one of these diagrams:

 https://www.pololu.com/product/3670#lightbox-picture0J10399

for this board.

Also a pin-for-pin documentation of where the board hard-connects show up on the feather footprint.

Thread 29 (2020-12-15):

IR receiver connected to an output only pin- Swap to pin 35

gcl8a, 2020-12-15:
The IR receiver is connected to pin 15. But the interface board page says that pin is output only.

Unless I'm mistaken about the pin functionality, this is a critical issue.

gcl8a, 2020-12-15:
After some testing, the pin works. Maybe this board has different functionality? I'll close this out, but I'm curious about the apparent contradiction.

madhephaestus, 2020-12-15:
Thats a good point actually, that pin is one of the strapping pins and needs to be held in 3.3v at boot time for the chip to boot.

gcl8a, 2020-12-15:
Luckily, the sensor is active low, so it’s generally high at upload.

Still, the reason I was looking into it was due to odd behavior. I did get it all working, but if there is a better solution, let’s do it.

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

madhephaestus, 2020-12-15:
For C term, it will just be on 15 and we tell them to plug the sensor in after programming, or that the sensor might interrupt programming if you send a signal while booting.

gcl8a, 2020-12-15:
And make it clear that if you’re having trouble uploading, one of the first things to try is removing the sensor.

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

acamilo, 2020-12-15:
The sensor is socketed, Instructing the students to remove it if they're having boot problems is what we'll have to do. In future revisions of the board we will switch it to GPIO35

madhephaestus, 2020-12-15:
Leave the issue open until the pin is swapped then

Thread 30 (2020-12-15):

Jumper wire near voltage regulators?

gcl8a, 2020-12-15:
I assume this little jumper wire near the voltage regulators is being replaced with a trace, yes?

acamilo, 2020-12-15:
yes, that was a manufacturing defect. We got a partial refund because of it.

Closed 2020-12-15.

Thread 31 (2021-01-01):

Servo power connected?

gcl8a, 2021-01-01:
On my version, there is only ~200mV on the 5V pin at the servo socket.

Is this just my board?

gcl8a, 2021-01-01:
False alarm. Tricked by the power LED -- I thought the power was on, even though I only had the USB plugged in.

Closed 2021-01-01.

Thread 32 (2021-01-29):

the GPIO numbers for the SPI bus on the ESP32 pins in the diagram are all wrong

madhephaestus, 2021-01-29:
It says 17/17/16/17 none of which are correct.

madhephaestus, 2021-01-29:
uuum now its all 17...

Closed 2021-01-29.
