WPIRoboticsEngineering/ZenDriver/(commit log)

2020-09-22 Layout done, Beginning work on silk.
    [Romi-unified-board.dsn, Romi-unified-board.kicad_pcb, Romi-unified-board.sch, outline.dxf]
2020-10-08 Re-routed board
    Resolved issues #6 and #5
    [Romi-unified-board.dsn, Romi-unified-board.kicad_pcb, Romi-unified-board.sch]
2020-10-09 Advanced board with IO muxing
    [Romi-unified-board-advanced.kicad_pcb, Romi-unified-board-advanced.sch]
2020-10-09 minor updates
    [Romi-unified-board-advanced.sch]
2020-10-11 Finished schematic
    [Romi-unified-board-advanced.sch]
2020-10-13 back traces away from holes.
    [Romi-unified-board.kicad_pcb]
2020-10-13 flipped ultrasonic, removed IO2 from j8
    [Romi-unified-board.kicad_pcb, Romi-unified-board.sch]
2020-10-13 Added silk.
    [Romi-unified-board.kicad_pcb]
2020-10-13 Fixed DRC errors, generated gerbers.
    [Romi-unified-board.kicad_pcb]
2020-10-25 generated BOM
    [Romi-unified-board-bom.csv, Romi-unified-board.kicad_pcb]
2020-10-27 Changes for rev2
    rotated Q2
    Fixed too-thin trace in DC-DC Circuit.
    Created correct footprint for U1. No 9th pad.
    [Romi-unified-board.kicad_pcb, Romi-unified-board.sch]
2020-10-27 Motor Disable is now a physical switch.
    #7
    [Romi-unified-board.kicad_pcb, Romi-unified-board.sch]
2020-10-29 Rev2
    Added smart servo connectors
    Added IR sensor
    Updated silk label
    [Romi-unified-board.kicad_pcb, Romi-unified-board.sch]
2020-10-29 More rev2 changes
    Fixed inductor FP
    Swapped out accelerometer with an in stock variant.
    [Romi-unified-board.kicad_pcb, Romi-unified-board.sch]
2020-10-29 clean up accel schematic
    [Romi-unified-board.sch]
2020-10-29 Widen Battery tab footprints
    [Romi-unified-board-bom.csv, Romi-unified-board.kicad_pcb]
2020-10-29 Added ir sensor to bom
    [Romi-unified-board-bom.csv]
2020-10-29 added fiducials
    [Romi-unified-board.kicad_pcb, Romi-unified-board.sch]
2020-10-29 Create PCBWay-BOM.xls
    pcbway formatted BOM
    [PCBWay-BOM.xls]
2020-10-30 Fixed error in netlist.
    [Romi-unified-board.kicad_pcb, Romi-unified-board.sch]
2020-10-30 Swapped pins 16 and 17
    #10
    [Romi-unified-board.kicad_pcb, Romi-unified-board.sch]
2020-10-30 Trace edit.
    [Romi-unified-board.kicad_pcb]
2020-10-30 Fixed ultrasonic
    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
    [Romi-unified-board.kicad_pcb, Romi-unified-board.sch]
2020-11-01 Batch of changes
    Fixed Switch footprint
    Swapped left and right H bridges to match shim.
    Updated silkscreen
    Fixed ultrasonic pinout.
    [Romi-unified-board.kicad_pcb, Romi-unified-board.sch]
2020-11-01 Updated Silkscreen
    [Romi-unified-board.kicad_pcb]
2020-11-02 Minor Changes
    Updated switch part.
    Removed LIDAR connector and IMU.
    [Romi-unified-board.dsn, Romi-unified-board.kicad_pcb, Romi-unified-board.sch]
2020-11-11 Swapped right motor -+
    #18
    [PCBWay-BOM.xls, Romi-unified-board.sch, jig.kicad_pcb]
2020-11-11 Update switch footprint.
    [Romi-unified-board.kicad_pcb]
2020-11-24 updated gitignore, fixed plot settings
    [Romi-unified-board.kicad_pcb]
2020-11-26 Make unwanted silkscreen features invisable.
    [Romi-unified-board.kicad_pcb]
2020-12-18 Added jig PCB
    [jig.kicad_pcb, jig.sch]
2020-12-18 libraries for jig PCB
2020-12-18 Pin diagram, incomplete.
    Artwork layout/style done, some of the values are correct.
2021-01-28 Create ZenDriver-Pinouts.svg
    Pinouts for esp32 and feather/samd51
2021-01-29 Fixed error in SPI pins
    #32
2021-03-24 Rev 4
    [Romi-unified-board-2layer-PRE.kicad_pcb, Romi-unified-board-2layer.kicad_pcb, Romi-unified-board-2layer.sch, Romi-unified-board.kicad_pcb]
